Stranjer7/STM32F105-Development-Board/README.md

# STM32F105-Development-Board
This repository includes design files for a custom STM32-based development platform
