Stranjer7/STM32F105-Development-Board/STM32F105 Devlopment Board.step

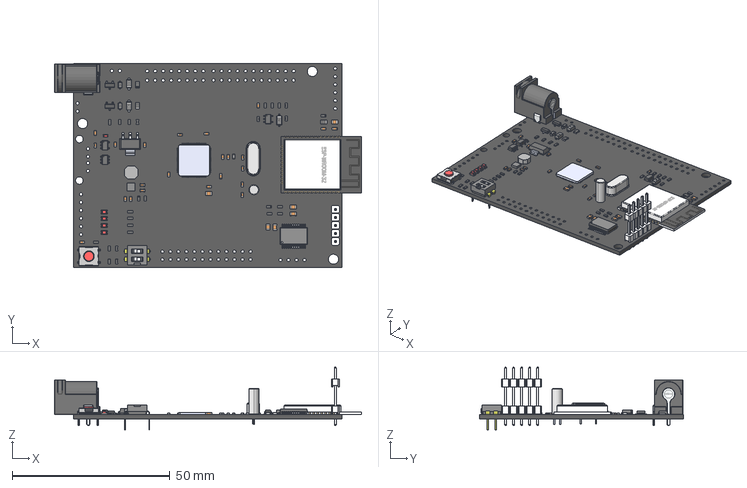
[picture p8: CAD file, 2026-03-05]
STM32F105 Devlopment Board.step
97.3 x 64.6 x 19.9 mm
