Stranjer7/STM32F105-Development-Board/STM32F105 Board Schematic.pdf

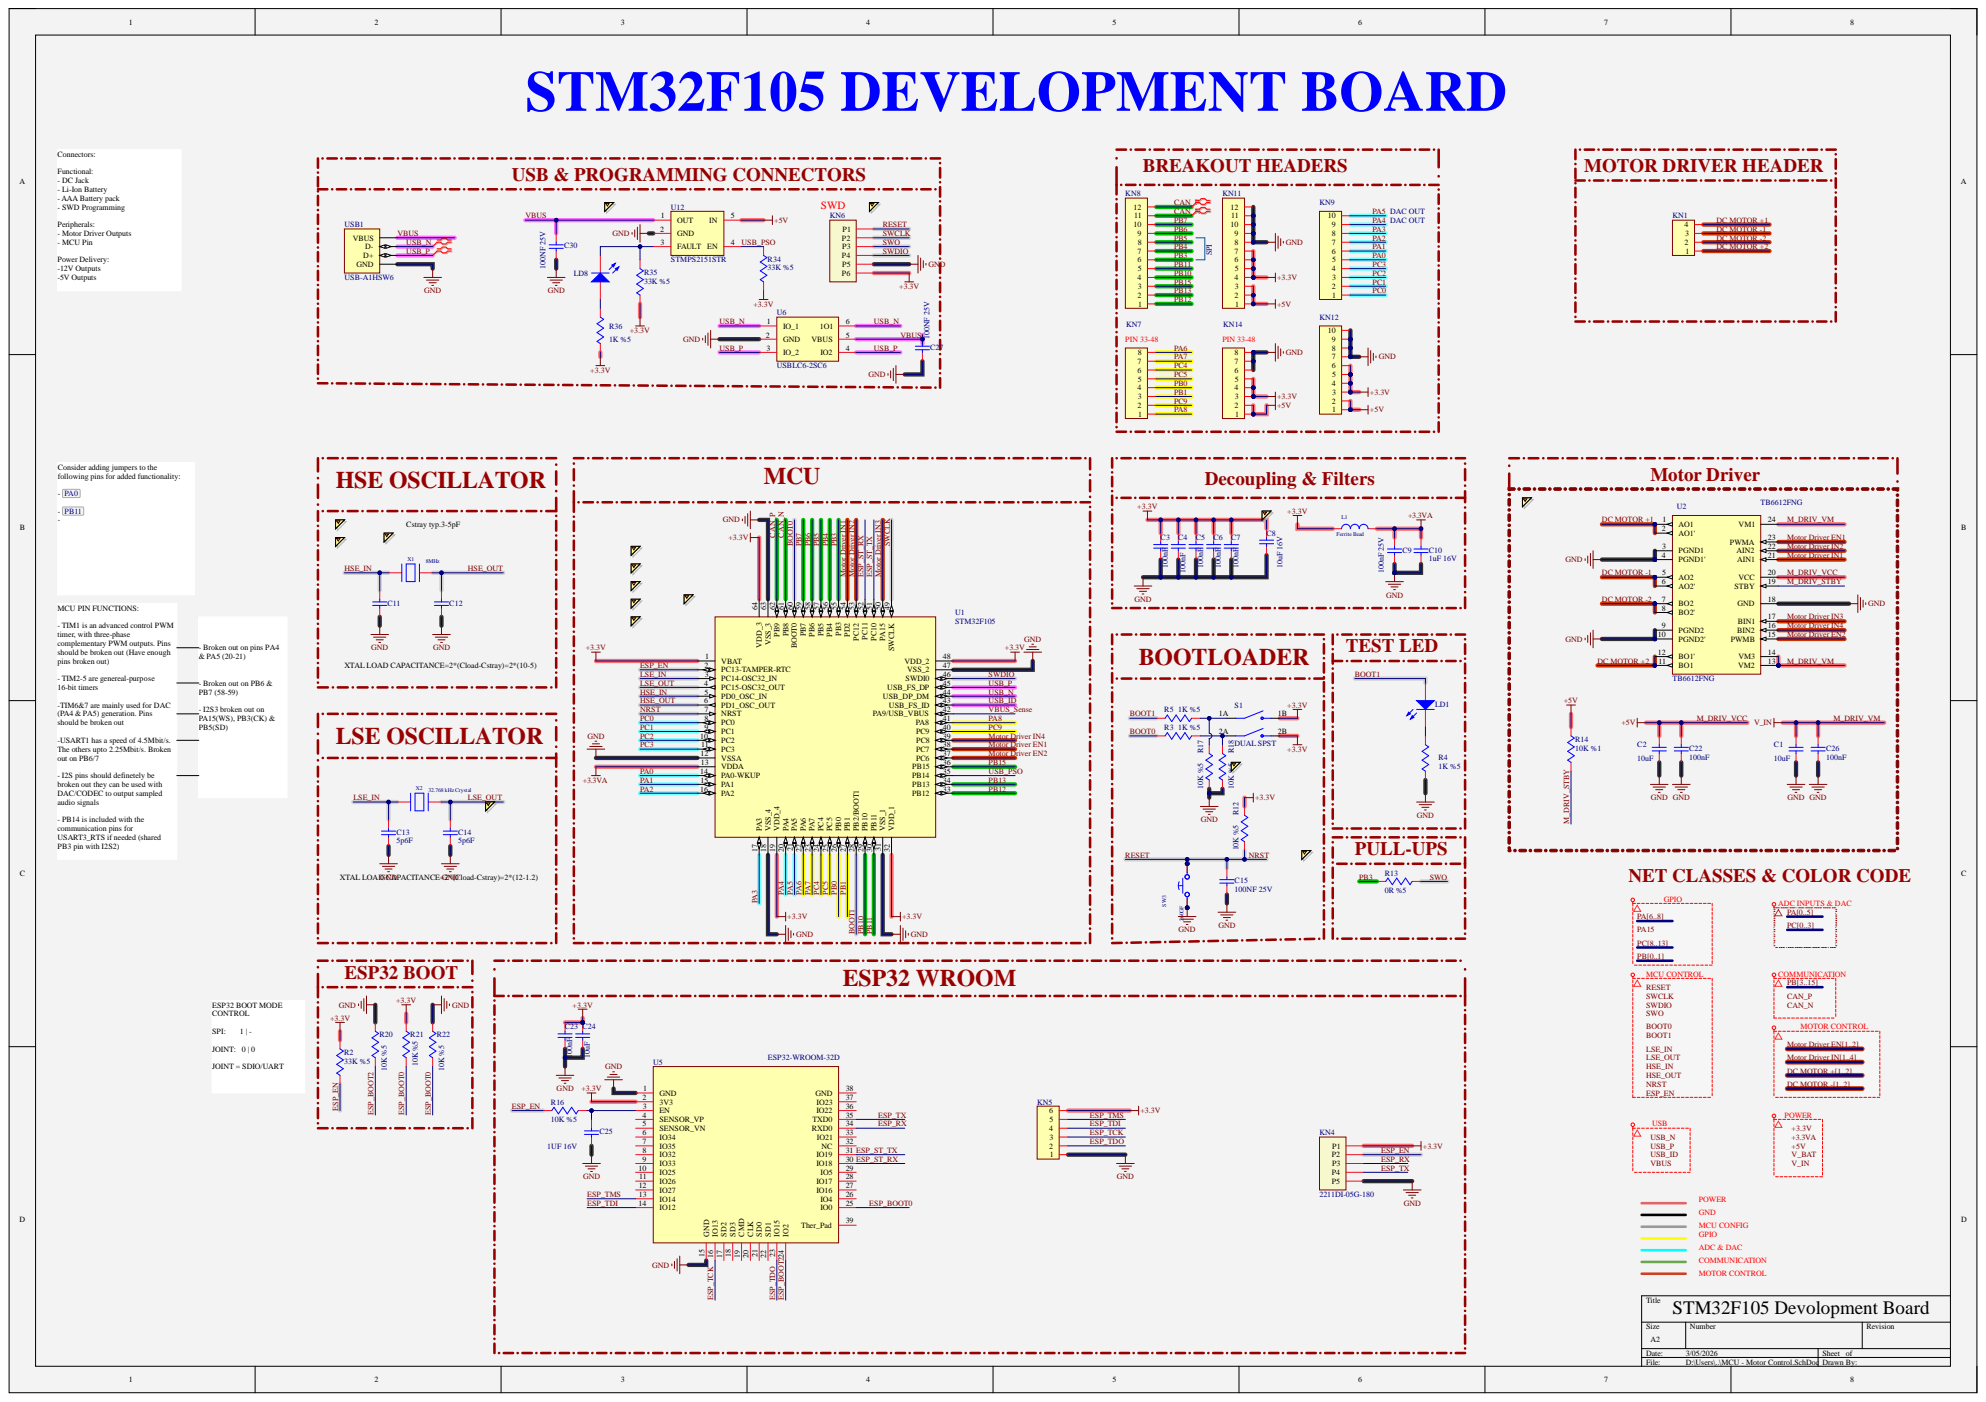
[picture p9: page 1]

Consider adding jumpers to the
following pins for added functionality:

- TIM1 is an advanced control PWM
timer, with three-phase
complementary PWM outputs. Pins
should be broken out (Have enough
pins broken out)

- Broken out on pins PA4

XTAL LOAD CAPACITANCE=2*(Cload-Cstray)=2*(10-5)

-TIM6&7 are mainly used for DAC
(PA4 & PA5) generation. Pins
should be broken out

-USART1 has a speed of 4.5Mbit/s.
The others upto 2.25Mbit/s. Broken
out on PB6/7

- I2S pins should definetely be
broken out they can be used with
DAC/CODEC to output sampled
audio signals

- PB14 is included with the
communication pins for
USART3_RTS if needed (shared
PB3 pin with I2S2)

XTAL LOAD CAPACITANCE=2*(Cload-Cstray)=2*(12-1.2)

NET CLASSES & COLOR CODE

ADC INPUTS & DAC GPIO

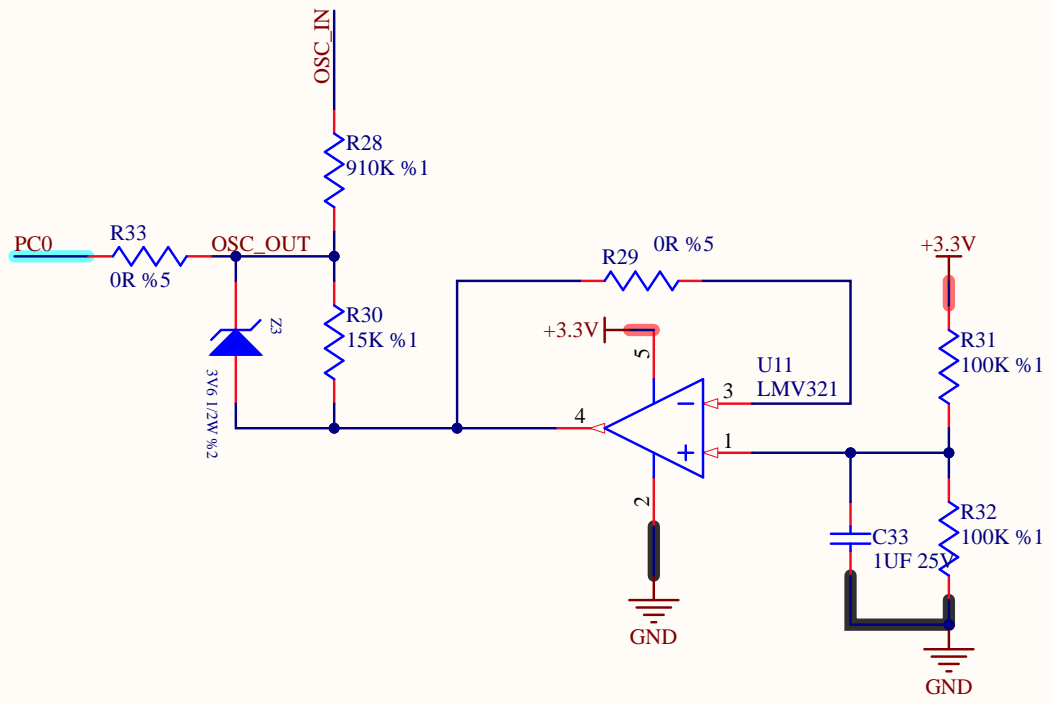
[picture p10: page 2]

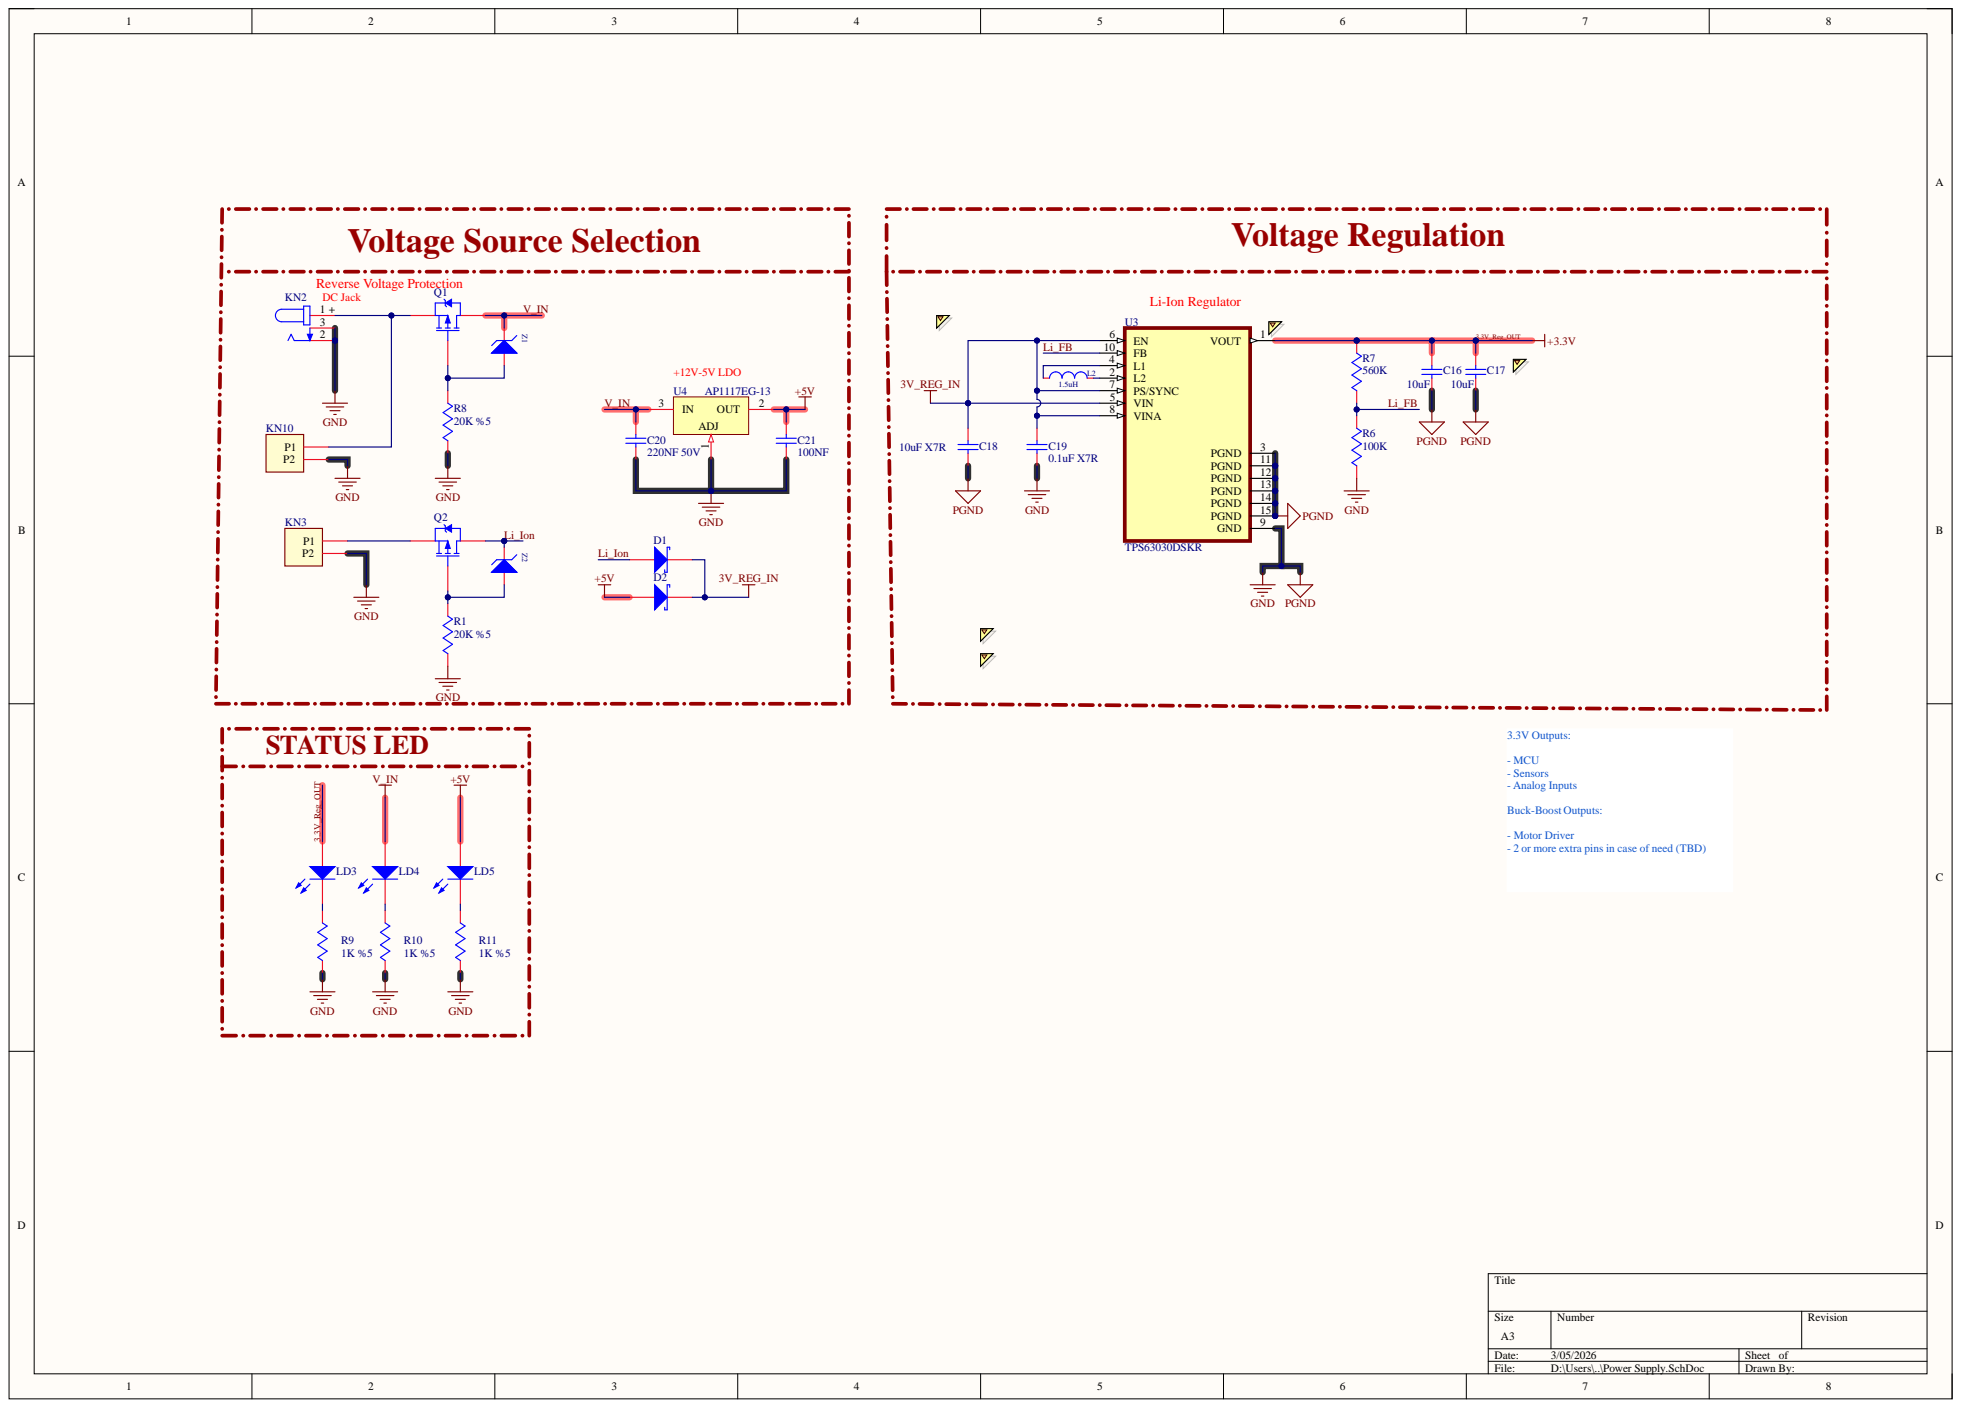
[picture p11: page 3]

- Motor Driver
- 2 or more extra pins in case of need (TBD)
