Stranjer7/STM32F105-Development-Board/(list of files, drawings)

Other design files:
STM32F105 Devlopment Board.PcbDoc
