Stranjer7/STM32F105-Development-Board/(commit log)

2026-03-05 Add files via upload
    Schematic Files
2026-03-05 Add files via upload
    PCB Design File
    [STM32F105 Devlopment Board.PcbDoc]
2026-03-05 3D Step File
    [STM32F105 Devlopment Board.step]
2026-04-06 Document highlights the features of the board
